davimqz/Embarcados/hardware/silo-3d/stl/4_tampa_silo.stl

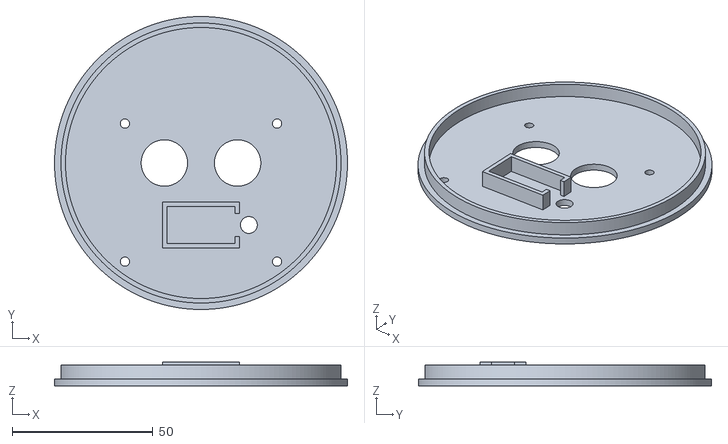
[picture p2: CAD file, 2026-10-22]
hardware/silo-3d/stl/4_tampa_silo.stl
104.0 x 104.0 x 8.40
