davimqz/Embarcados/hardware/silo-3d/stl/5_capa_sensor.stl

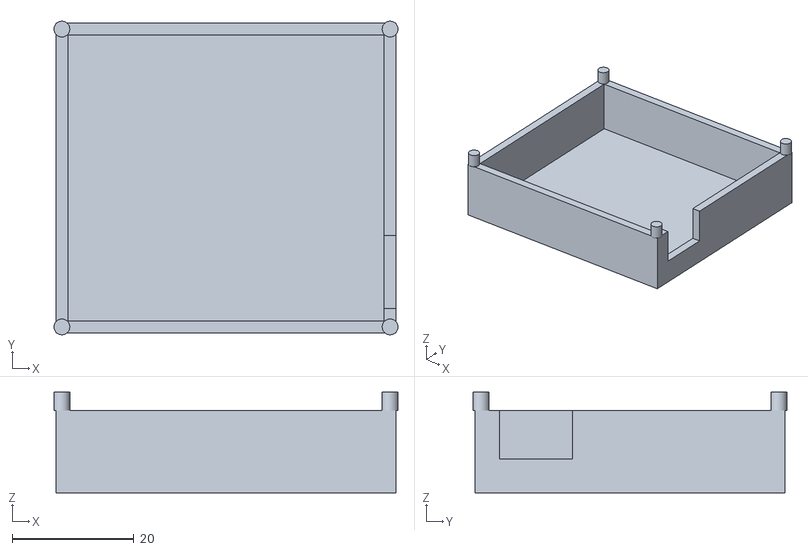
[picture p3: CAD file, 2026-10-22]
hardware/silo-3d/stl/5_capa_sensor.stl
56.6 x 51.6 x 16.6
