davimqz/Embarcados/hardware/silo-3d/stl/6_escotilha.stl

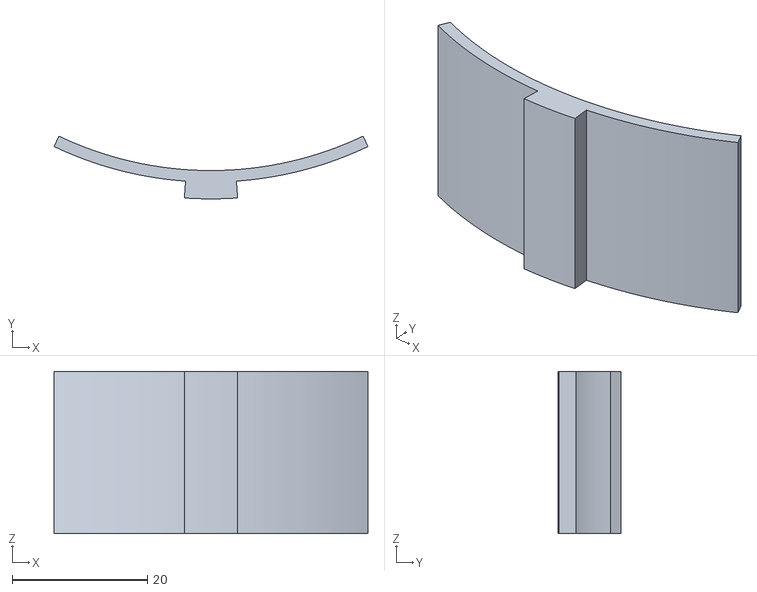
[picture p4: CAD file, 2026-10-22]
hardware/silo-3d/stl/6_escotilha.stl
46.5 x 9.29 x 24.0
