davimqz/Embarcados/hardware/silo-3d/stl/1_base.stl

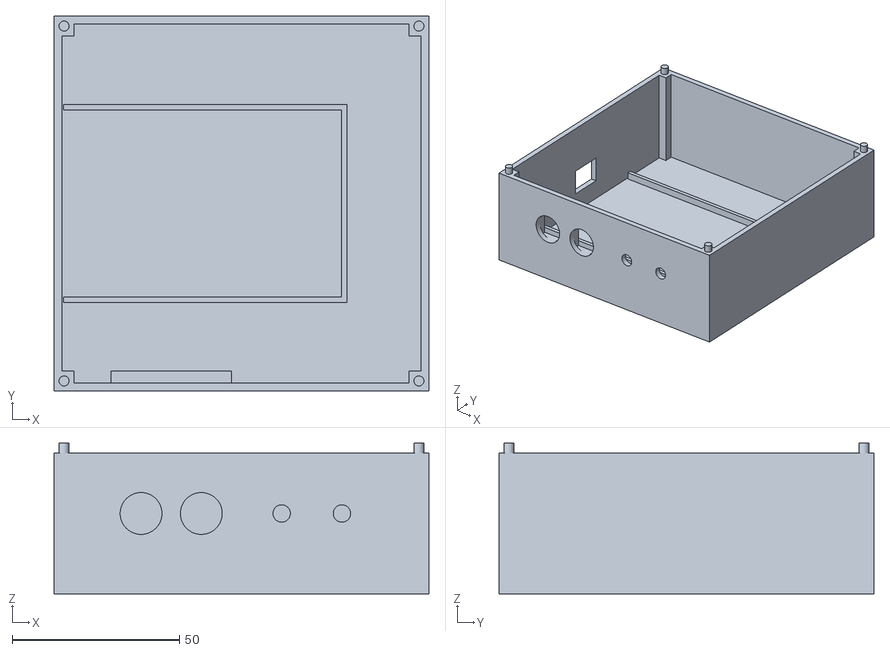
[picture p5: CAD file, 2026-10-22]
hardware/silo-3d/stl/1_base.stl
112.0 x 112.0 x 45.0
