davimqz/Embarcados/hardware/silo-3d/stl/2_tampa_base.stl

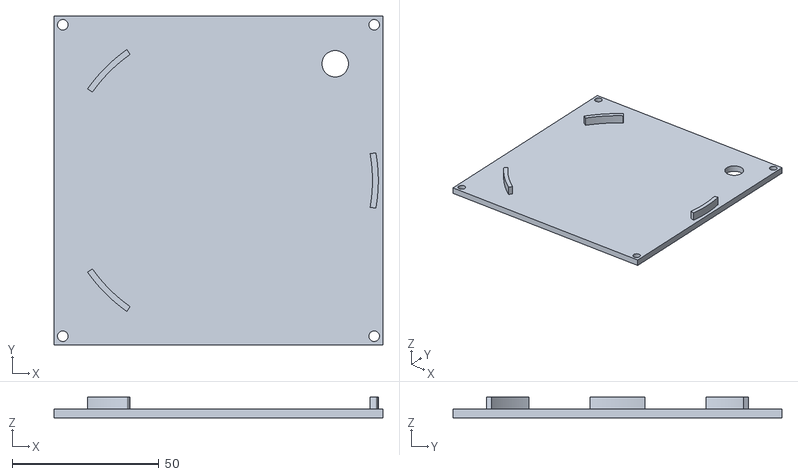
[picture p6: CAD file, 2026-10-22]
hardware/silo-3d/stl/2_tampa_base.stl
112.0 x 112.0 x 7.00
