davimqz/Embarcados/hardware/silo-3d/stl/3_corpo.stl

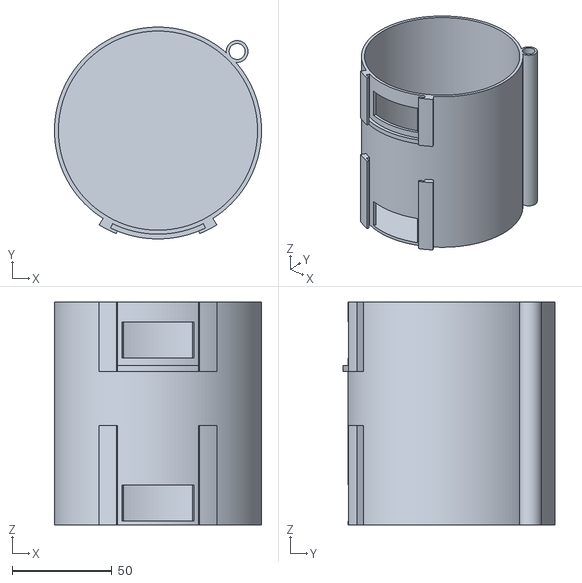
[picture p7: CAD file, 2026-10-22]
hardware/silo-3d/stl/3_corpo.stl
104.0 x 106.4 x 112.0
