davimqz/Embarcados/hardware/silo-3d/stl/0_peca_teste.stl

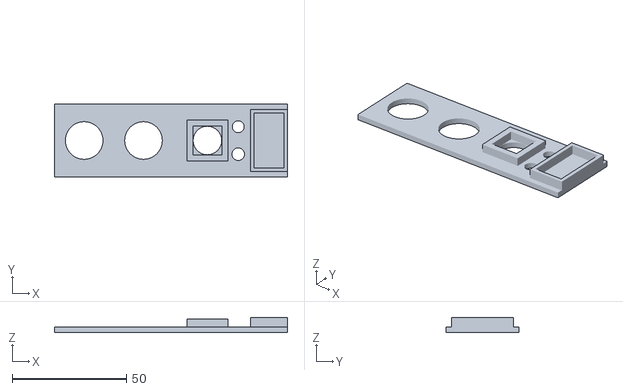
[picture p8: CAD file, 2026-10-22]
hardware/silo-3d/stl/0_peca_teste.stl
102.1 x 32.0 x 6.40
