davimqz/Embarcados/(commit log)

2026-10-13 chore(infra): criar estrutura de pastas, gitignore e readme inicial
    .gitignore bloqueia config.h, .env, chaves/mnemônicos, .pio, node_modules
    e bancos SQLite locais desde o primeiro commit.
    Refs: T0.1
2026-10-13 chore(firmware): migrar código da ap02 e extrair segredos para config.h
    Código da AP02 trazido sem mudança de comportamento; SSID, senha, IP do
    broker e nº do grupo vão para config.h (ignorado), com config.example.h
    versionado. Build falha com #error claro se config.h faltar.
    Refs: T0.2
    [config.example.h, main.cpp]
2026-10-13 chore(infra): adicionar projeto platformio base e gitignore
    Ignora config.h, .env, node_modules e banco local para impedir
    vazamento de segredos desde o primeiro commit.
    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
2026-10-13 docs(docs): adicionar regras de commit, tasks e marcos
    Inclui o roadmap M0–M6, o backlog do M0 em TASKS.md e o
    template de mensagem de commit.
    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
2026-10-15 chore(infra): mover projeto platformio para firmware/
    Separa o firmware das futuras pastas backend/ e dashboard/. As
    regras de .vscode no gitignore passam a valer em qualquer pasta,
    pois o PlatformIO agora gera esses arquivos em firmware/.vscode/.
    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
2026-10-15 docs(docs): adicionar readme e estrutura de pastas do projeto
    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
2026-10-15 chore(infra): ignorar config.h no .gitignore do firmware
    O .gitignore da raiz está apagado no working tree; sem esta regra o
    config.h (com SSID e senha do Wi-Fi) ficaria visível para o git.
    Refs: —
2026-10-15 feat(firmware): contar entrada e saída de lotes do silo com dois botões
    Amarelo (GPIO 19) conta entrada e vermelho (GPIO 18) conta saída,
    mantendo ISR -> semáforo -> task -> fila -> TaskComunicacao.
    Inclui mutex no Serial, debounce por confirmação de 50 ms, descarte
    dos 2 s iniciais, log de WiFi.status() e modo de teste dos pinos.
    WIP: última versão (ISR sem trava de tempo) ainda não testada na placa.
    Refs: — (sem task; ver docs/sessoes/2026-10-15-botoes-silo.md)
2026-10-15 docs(docs): registrar relatório da sessão dos botões do silo
    Estado atual, decisões, pontos suspeitos e próximos passos para
    retomar o trabalho.
    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
2026-10-20 fix(firmware): mover botão vermelho (saída) do GPIO 18 para o 21
    O D18 não ia a LOW ao apertar o vermelho, mesmo trocando o botão de
    posição. No GPIO 21 os dois botões funcionaram na placa: 3 entradas e
    3 saídas contadas, sem ruído no D19 após trocar jumper e fileira.
    Valida também a ISR sem trava de tempo do commit anterior.
    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
    [main.cpp]
2026-10-20 chore(firmware): remover modo de diagnóstico dos pinos
    Com o ruído do D19 resolvido no hardware, a TaskTestePinos e o contador
    Botao::ruidos deixam de ser necessários. O contador era lido por outra
    task sem proteção. Validado na placa: 3 entradas + 3 saídas -> saldo=0.
    Também versiona o .vscode/extensions.json gerado pelo PlatformIO.
2026-10-20 feat(firmware): publicar eventos do silo em JSON com ts via NTP
    Payload em grupo3/silo/evento com device_id, ts, seq, evento e os
    contadores (contrato em docs/topicos-mqtt.md). O ts é marcado no aperto
    e vai pela fila junto com o tipo do evento, então eventos que esperaram
    o broker mantêm o horário certo; fica null enquanto o NTP não sincroniza.
    O tópico legado /botao/status deixa de ser publicado.
    Dependência nova: ArduinoJson, para montar o JSON sem snprintf manual.
    Validado na placa: 3 entradas + 3 saídas -> seq 1..6, saldo=0, ts ok.
    [main.cpp]
2026-10-20 chore: restaurar documentação, regras e entregas do M0
    Desfaz a remoção do commit 13b1e18: CLAUDE.md (regras e marcos),
    TASKS.md (backlog), README.md, .gitignore, .gitattributes e as
    evidências de docs/entregas/M0. Os arquivos são necessários para seguir
    o processo do projeto.
2026-10-20 feat(mqtt): reconectar sem bloquear e publicar status com LWT
    As conexões Wi-Fi e MQTT viram uma tentativa a cada 5 s, em vez de um
    laço que prendia a TaskComunicacao e deixava a fila encher. O evento só
    sai da fila depois de publicado, então uma queda não perde evento nem
    abre buraco no seq. Ao conectar, a placa publica online (retido) em
    grupo3/status e deixa offline como LWT; keep-alive de 30 s para 15 s
    para o offline aparecer mais rápido.
    Validado na placa: online ao conectar e reconexão sem reset.
    Refs: T1.3
    [main.cpp]
2026-10-20 refactor(firmware): separar botões, wifi/mqtt e log serial em módulos
    O main.cpp fica com o setup() e a TaskComunicacao (contadores e JSON do
    silo); a leitura dos botões vai para botao.*, a conexão e o LWT para
    wifi_mqtt.* e o logSerial com o mutex para log_serial.*. Sem mudança de
    comportamento: mesmos logs, mesma ordem de inicialização e mesmo payload.
    Validado na placa: 3 entradas + 3 saídas -> seq 1..6, saldo=0.
    Refs: T1.1
2026-10-20 docs(docs): registrar evidência da T1.1 e teste de fila da T1.3
    Refs: T1.1, T1.3
2026-10-20 docs(docs): fechar T1.3 com o teste de LWT ao desligar a placa
    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
2026-10-20 docs(docs): remover o SSID da rede dos logs de evidência
    O CLAUDE.md §3 trata o SSID como segredo (só no config.h). Os logs do
    monitor serial e o relatório da sessão citavam o nome da rede.
    Refs: T1.1, T1.3, T1.4
2026-10-20 docs(docs): listar as decisões pendentes para fechar o projeto
    Cada item tem o que decidir, por que importa, opções, recomendação e o
    que fica travado. T0.3 e T0.4 vão para done; T0.5 fica blocked até a
    escolha do sensor, do atuador e da pinagem.
    Refs: T0.5
2026-10-20 docs(docs): adicionar resumo da entrega do M1
    Exigido pelo checklist de fechamento de marco (docs/regras/marcos.md).
    Refs: T1.1, T1.2, T1.3, T1.4, T1.5
2026-10-22 docs(docs): registrar sensor, atuador, pinagem, intervalo e limiar
    Itens 1-5 das decisões pendentes, a partir dos componentes que o grupo
    já tem (DHT11, HC-SR04, LEDs). Destrava a T0.5.
    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
2026-10-22 docs(docs): escrever arquitetura com hardware, pinagem e medidas 3d
    Inclui as medidas nominais das peças para o grupo modelar o silo na
    impressora 3D (mesa de 12 x 12 cm); as medidas reais ficam a preencher.
    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
2026-10-22 docs(docs): ajustar restrições do silo ao volume de impressão 12 cm
    Divide o silo em base, corpo e tampa para caber no cubo de 12 cm e
    registra a coluna útil de grão que sobra para o HC-SR04.
    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
2026-10-22 docs(docs): adotar medidas padrão das peças para a impressão 3d
    O grupo optou por não medir as peças; as folgas maiores e a peça de
    teste cobrem a variação entre fabricantes. Fecha a T0.5.
    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
2026-10-22 docs(docs): usar medidas dos anúncios e ligar os leds rgb do grupo
    Os LEDs comprados são RGB de cátodo comum: a perna longa vai no GND,
    não no GPIO, e o canal azul/verde precisa de resistor menor a 3,3 V.
    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
2026-10-22 docs(docs): definir protoboard de 400 pontos com o esp32 encaixado
    Cabe na base de 12 x 12 cm, tem espaço para o ESP32 e os resistores e
    traz trilhos separados para 3,3 V (DHT11) e 5 V (HC-SR04).
    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
2026-10-22 feat(infra): modelar o silo em 3d e gerar os stls
    Base, tampa da base, corpo com escotilhas deslizantes e conduíte,
    tampa com HC-SR04 e DHT11, capa e peça de teste, todas dentro do
    volume de 120 mm da impressora do grupo.
    Dependência: manifold3d (só para gerar os STLs), porque não há
    OpenSCAD e ela faz operações booleanas de sólidos em Python puro.
    Refs: T0.7
    [0_peca_teste.stl, 1_base.stl, 2_tampa_base.stl, 3_corpo.stl, 4_tampa_silo.stl, 5_capa_sensor.stl, 6_escotilha.stl]
2026-10-22 docs(docs): apontar a arquitetura para o modelo 3d do silo
    O modelo mudou o diâmetro para 104 mm e levou botões e LEDs para a
    base, para os fios não passarem pelo grão.
    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
